HANJAEDUC/RP2350A_ISP/KakaoTalk_20260904_075419439.jpg

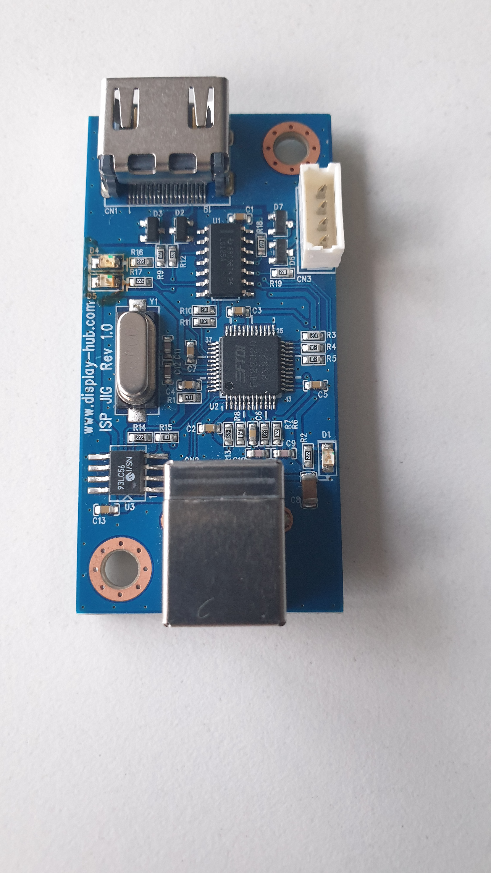
KakaoTalk_20260904_075419439.jpg
