HANJAEDUC/RP2350A_ISP/KakaoTalk_20260904_075456952.jpg

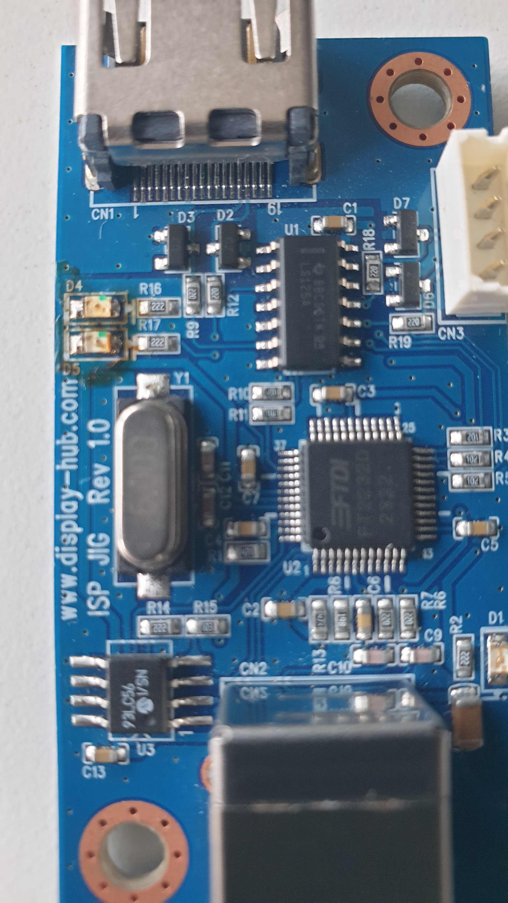
KakaoTalk_20260904_075456952.jpg
