HANJAEDUC/RP2350A_ISP/kicad/RP2350A-ISP.kicad_pcb

## KiCad design kicad/RP2350A-ISP.kicad_pcb (2026-09-07)

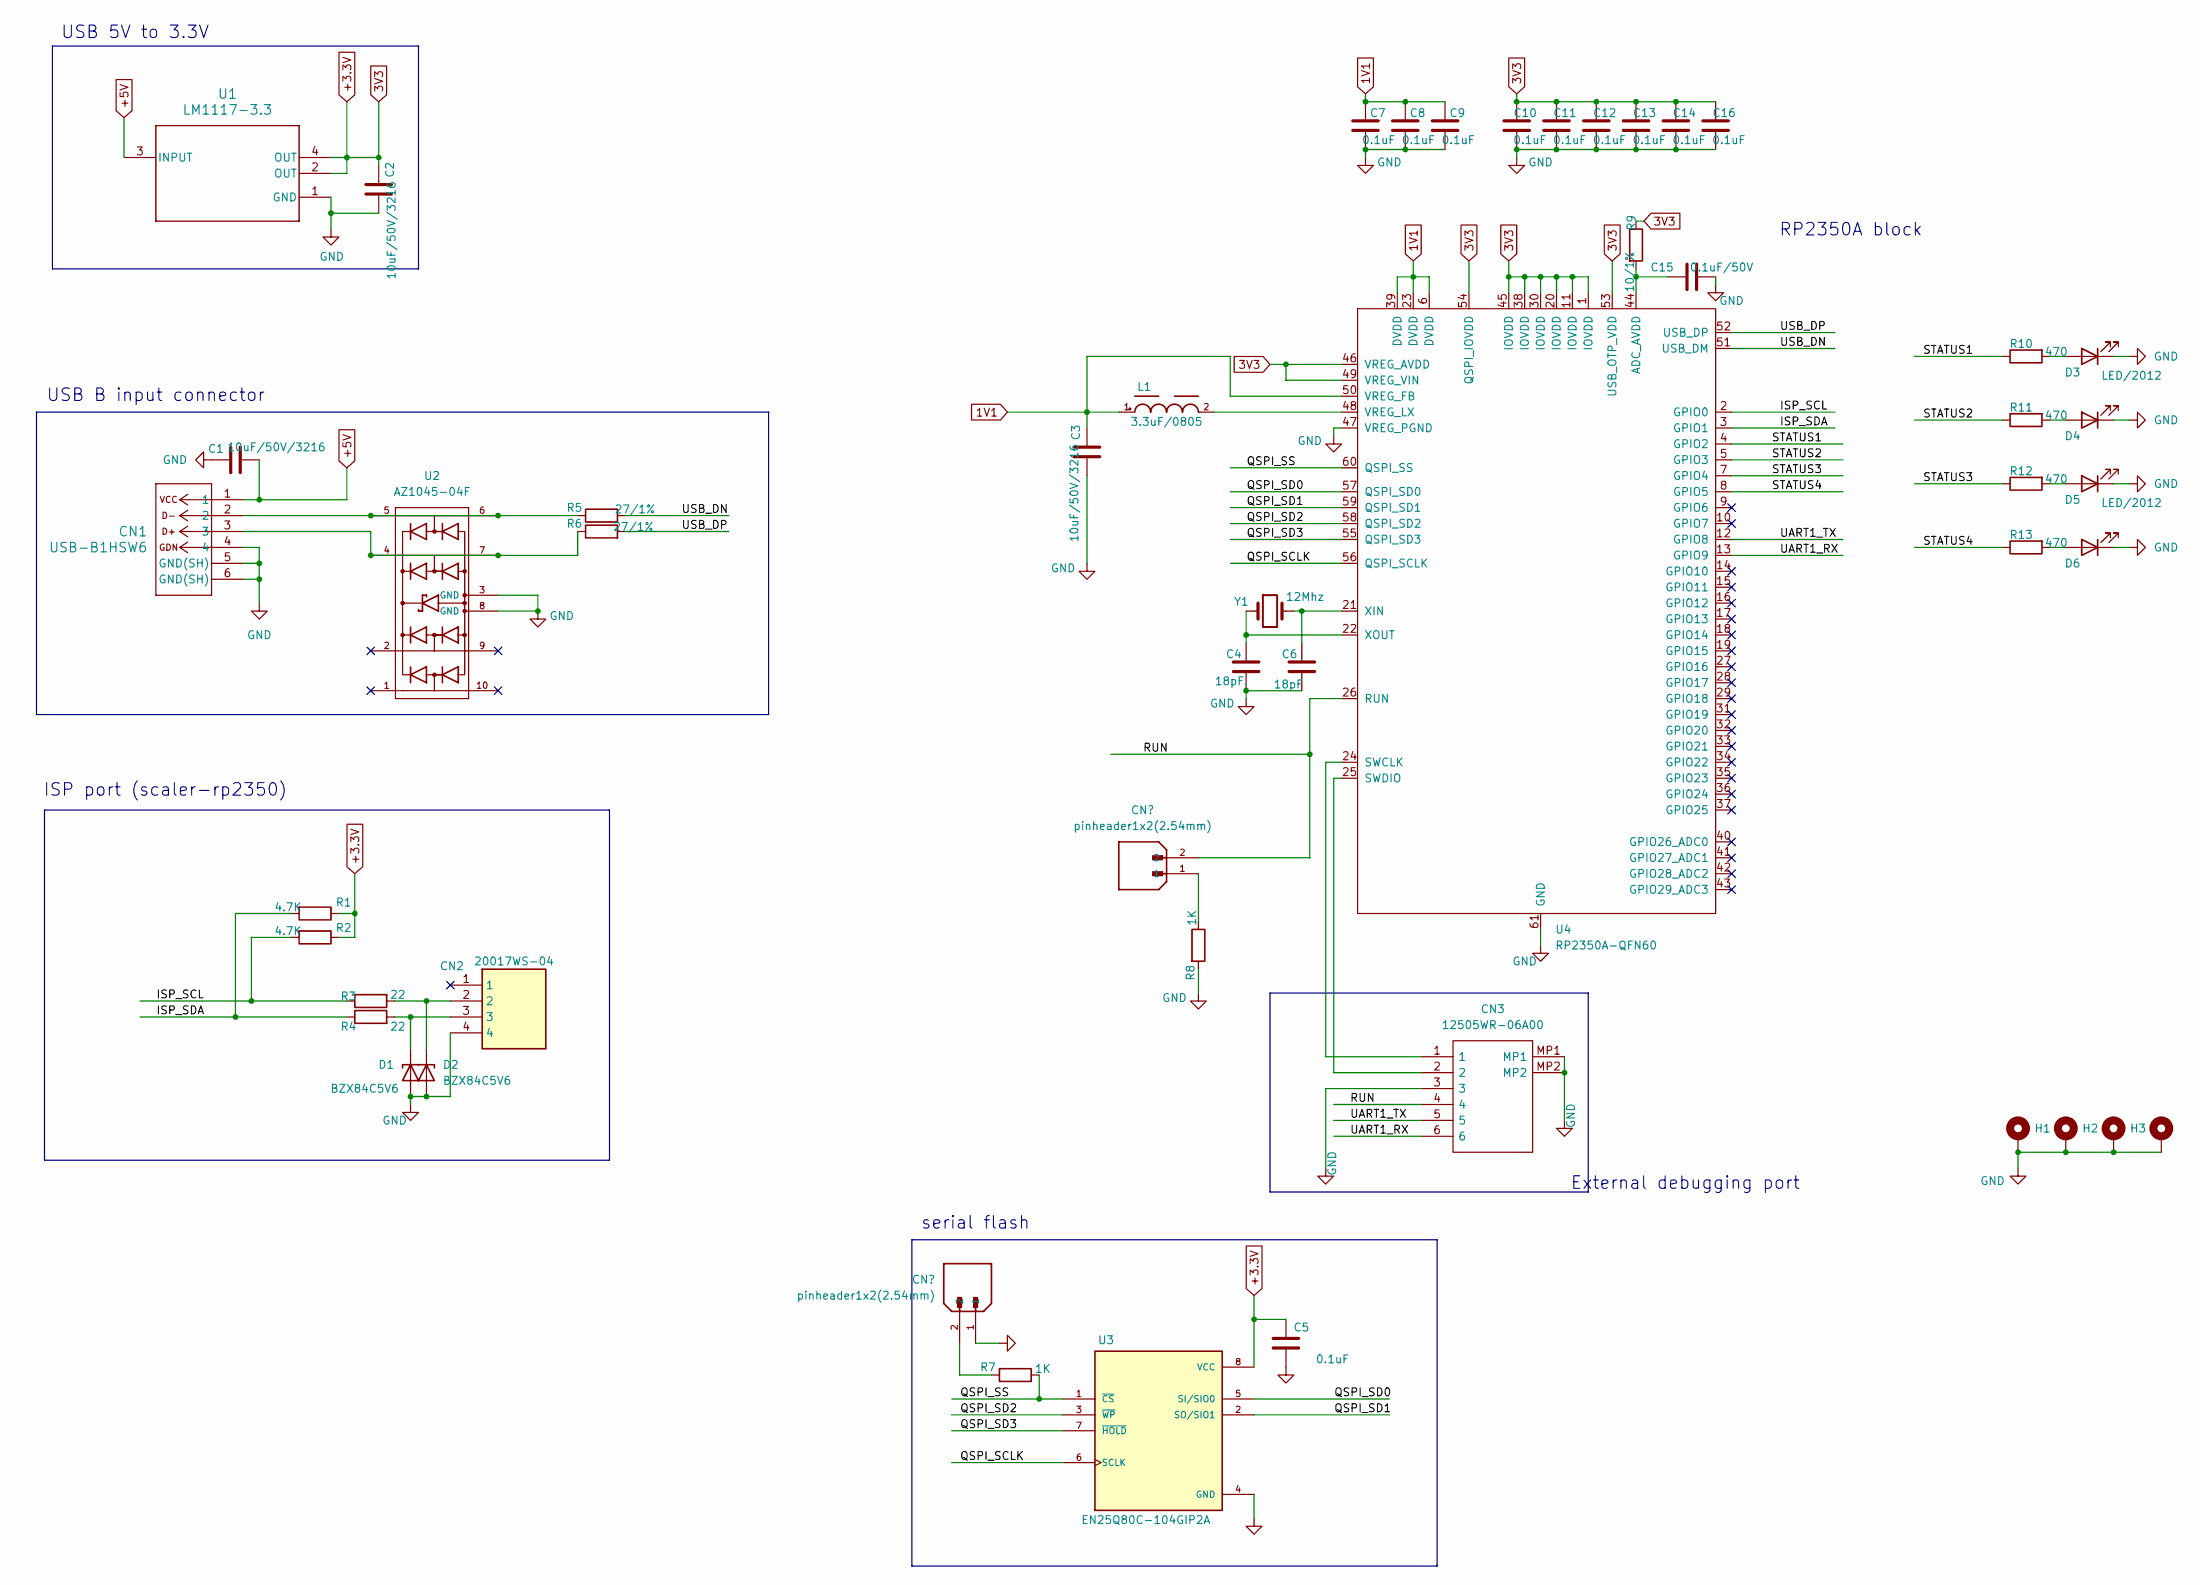
[picture p3: schematic RP2350A-ISP.kicad_sch]

Parts:
C1, C2, C3: 10uF/50V/3216; SMD-CAPACITOR(3216-1206)
C4: 18pF.; SMD-CAPACITOR(1608-0603)
C5, C7, C8, C9, C10, C11, C12, C13, C14, C16: 0.1uF; SMD-CAPACITOR(1608-0603)
C6: 18pF; SMD-CAPACITOR(1608-0603)
C15: 0.1uF/50V; SMD-CAPACITOR(1608-0603)
CN1: USB-B1HSW6; USB-B-CONN_USB-B1HSW6_OST
CN2: 20017WS-04
CN3: 12505WR-06A00; 12505WR06A00_1; Manufacturer_Part_Number 12505WR-06A00
D1, D2: BZX84C5V6
D3, D4, D5, D6: LED/2012; LED_0805_2012Metric
H1, H2, H3, H4: MountingHole_Pad; MountingHole_4mm_Pad_TopBottom
L1: 3.3uF/0805; SMD-RESISTOR(2012-0805)
R1, R2: 4.7K; SMD-RESISTOR(1608-0603)
R3, R4: 22; SMD-RESISTOR(1608-0603)
R5, R6: 27/1%; SMD-RESISTOR(1608-0603)
R7, R8: 1K; SMD-RESISTOR(1608-0603)
R9: 10/1%; SMD-RESISTOR(1608-0603)
R10, R11, R12, R13: 470; SMD-RESISTOR(1608-0603)
U1: LM1117-3.3; LM1117(SOT-223)
U2: AZ1045-04F; PARTREV N
U3: EN25Q80C-104GIP2A; MX25L8006EM1I-12G; PARTREV 1.6
U4: RP2350A-QFN60; RP2350A_QFN-60_EP_7.75x7.75_Pitch0.4mm
Y1: 12Mhz; Crystal_SMD_HC49-SD

Connections:
1V1: C3.1, C7.2, C8.2, C9.2, L1.1, U4.6 (DVDD), U4.23 (DVDD), U4.39 (DVDD), U4.50 (VREG_FB)
+3.3V: C2.1, C5.1, C10.2, C11.2, C12.2, C13.2, C14.2, C16.2, R1.1, R2.1, R9.1, U1.2 (OUT), U1.4 (OUT), U3.8 (VCC), U4.1 (IOVDD), U4.11 (IOVDD), U4.20 (IOVDD), U4.30 (IOVDD), U4.38 (IOVDD), U4.45 (IOVDD), U4.46 (VREG_AVDD), U4.49 (VREG_VIN), U4.53 (USB_OTP_VDD), U4.54 (QSPI_IOVDD)
+5V: C1.2, CN1.1, U1.3 (INPUT)
/ISP_SCL: R2.2, R3.1, U4.2 (GPIO0)
/ISP_SDA: R1.2, R4.1, U4.3 (GPIO1)
/QSPI_SCLK: U3.6 (SCLK), U4.56 (QSPI_SCLK)
/QSPI_SD0: U3.5 (SI/SIO0), U4.57 (QSPI_SD0)
/QSPI_SD1: U3.2 (SO/SIO1), U4.59 (QSPI_SD1)
/QSPI_SD2: U3.3 (~WP), U4.58 (QSPI_SD2)
/QSPI_SD3: U3.7 (~HOLD), U4.55 (QSPI_SD3)
/QSPI_SS: R7.1, U3.1 (~CS), U4.60 (QSPI_SS)
/RUN: CN3.4, U4.26 (RUN); also elsewhere on the board
/STATUS1: R10.1, U4.4 (GPIO2)
/STATUS2: R11.1, U4.5 (GPIO3)
/STATUS3: R12.1, U4.7 (GPIO4)
/STATUS4: R13.1, U4.8 (GPIO5)
/UART1_RX: CN3.6, U4.13 (GPIO9)
/UART1_TX: CN3.5, U4.12 (GPIO8)
/USB_DN: R5.2, U4.51 (USB_DM)
/USB_DP: R6.2, U4.52 (USB_DP)
GND: C1.1, C2.2, C3.2, C4.1, C5.2, C6.1, C7.1, C8.1, C9.1, C10.1, C11.1, C12.1, C13.1, C14.1, C15.2, C16.1, CN1.4, CN1.5 (GND(SH)), CN1.6 (GND(SH)), CN2.4, CN3.3, CN3.MP1, CN3.MP2, D1.1 (A), D2.1 (A), D3.1 (K), D4.1 (K), D5.1 (K), D6.1 (K), H1.1, H2.1, H3.1, H4.1, R8.2, U1.1 (GND), U2.3 (GND), U2.8 (GND), U3.4 (GND), U4.47 (VREG_PGND), U4.61 (GND); also elsewhere on the board
unnamed: CN1.2, R5.1, U2.5, U2.6
unnamed: CN1.3, R6.1, U2.4, U2.7
unnamed: CN2.3, D1.3 (K), R4.2
unnamed: CN2.2, D2.3 (K), R3.2
unnamed: D3.2 (A), R10.2
unnamed: D4.2 (A), R11.2
unnamed: D5.2 (A), R12.2
unnamed: D6.2 (A), R13.2
unnamed 29: R7.2; also elsewhere on the board
unnamed 30: R8.1; also elsewhere on the board
unnamed: C15.1, R9.2, U4.44 (ADC_AVDD)
unnamed: CN3.1, U4.24 (SWCLK)
unnamed: CN3.2, U4.25 (SWDIO)
unnamed: L1.2, U4.48 (VREG_LX)
unnamed: C6.2, U4.21 (XIN), Y1.2
unnamed: C4.2, U4.22 (XOUT), Y1.1

Notes on the sheet:
External debugging port
ISP port (scaler-rp2350)
serial flash
USB B input connector
RP2350A block
USB 5V to 3.3V

Board: 2 copper layers, 50 parts (0 on the bottom side), 37 nets, no tracks yet.

Other parts of the board:
SW1, SW2: Tactswitch

Their connections:
/RUN: SW2.3, SW2.4; also elsewhere on the board
GND: SW1.3, SW1.4; also elsewhere on the board
unnamed 29: SW1.1, SW1.2; also elsewhere on the board
unnamed 30: SW2.1, SW2.2; also elsewhere on the board
